mdeslaur/fm1608-to-5101/docs/top-3d.png

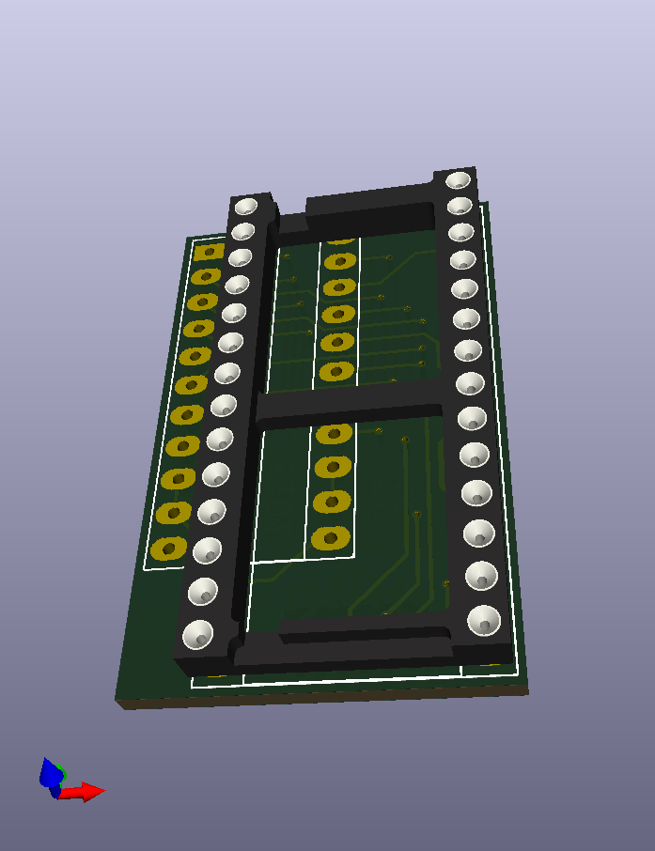
docs/top-3d.png
