mdeslaur/fm1608-to-5101/docs/bottom-3d.png

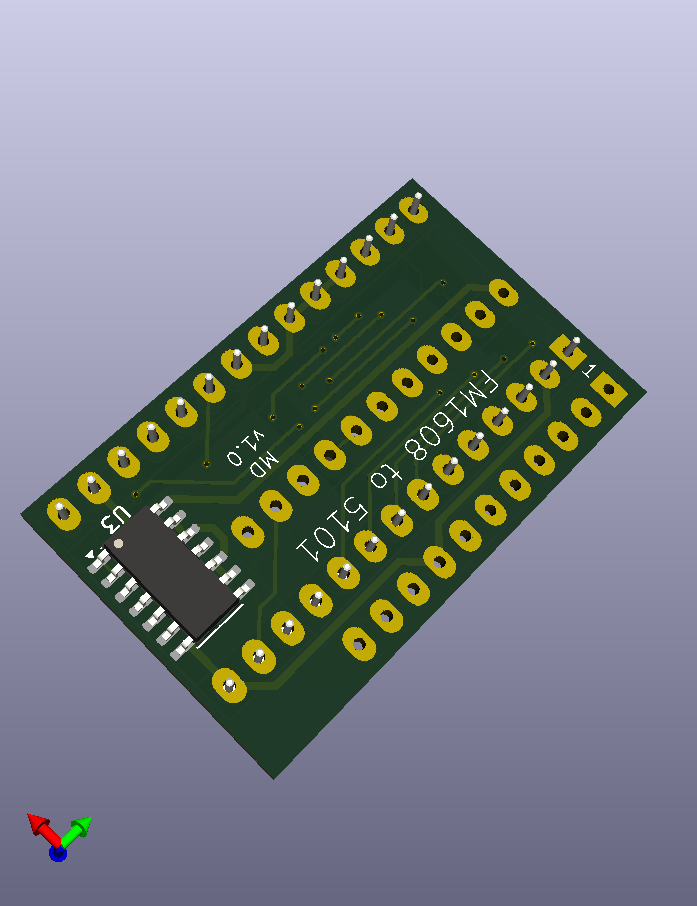
docs/bottom-3d.png
