mdeslaur/fm1608-to-5101/docs/fm1608-to-5101.pdf

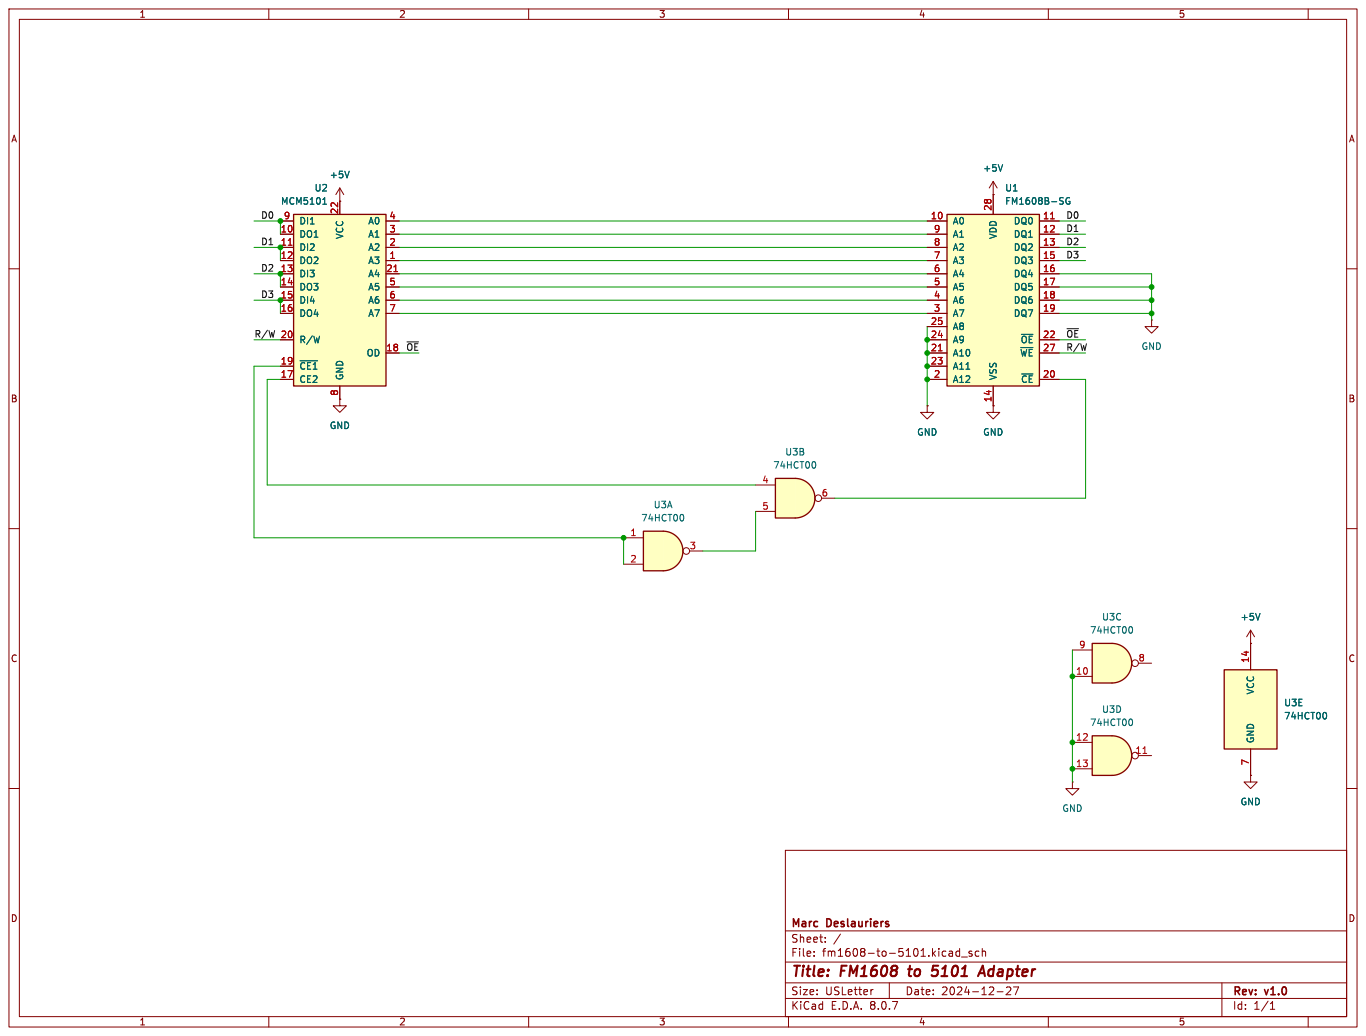
[picture p3: page 1]
