mdeslaur/fm1608-to-5101/fm1608-to-5101.kicad_pcb

## KiCad design fm1608-to-5101.kicad_pcb (2024-12-29)

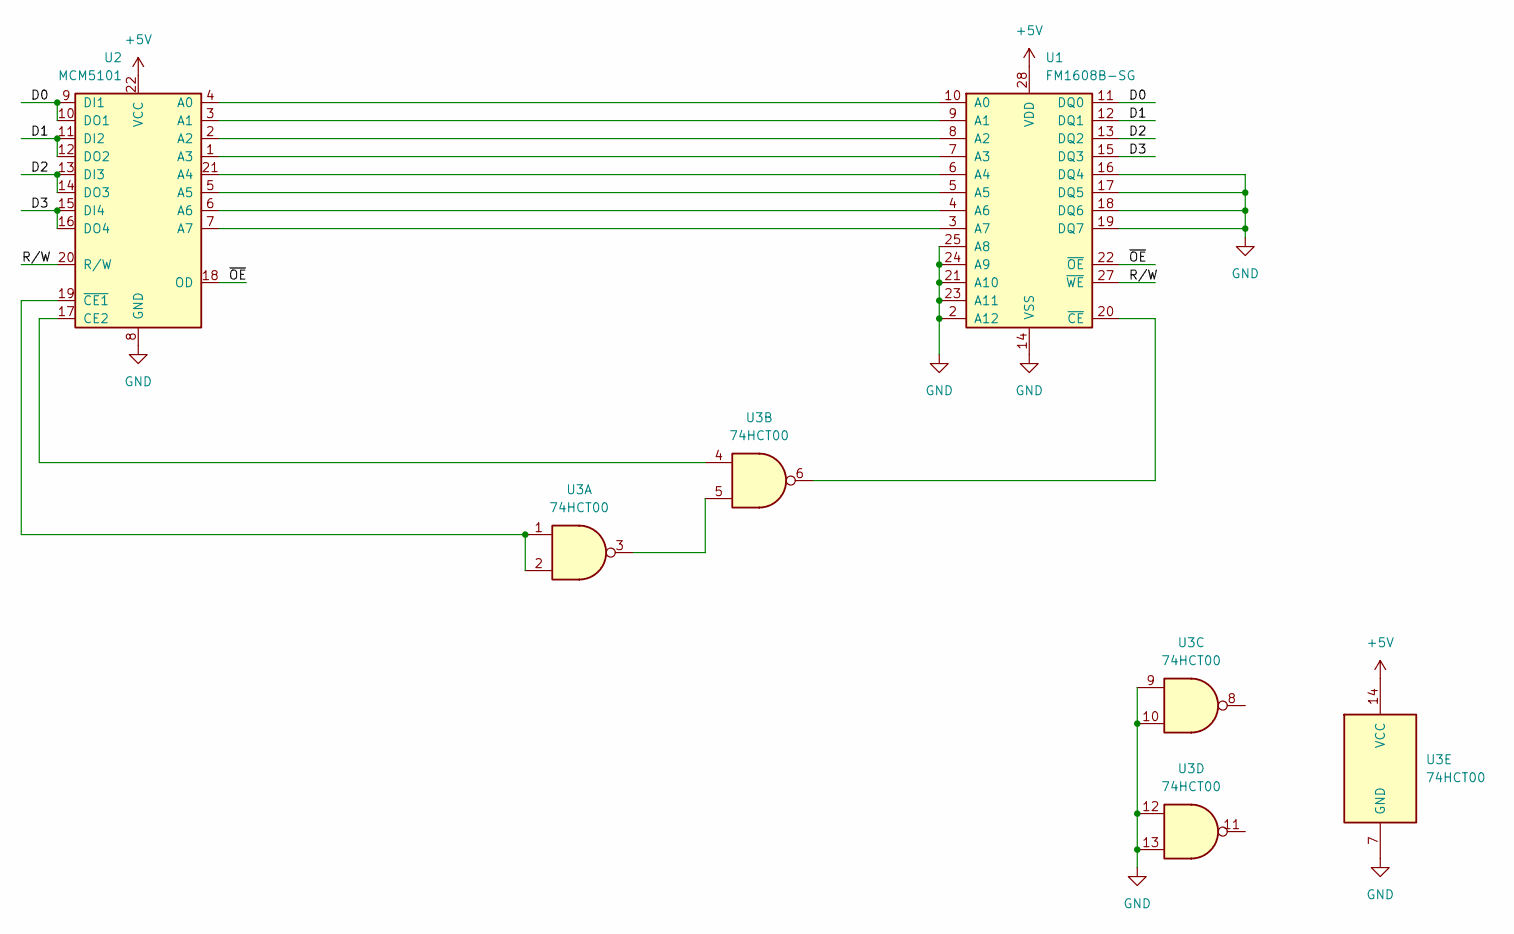
[picture p4: schematic fm1608-to-5101.kicad_sch, FM1608 to 5101 Adapter]

Parts:
U1: FM1608B-SG; DIP-28_W15.24mm_Socket_LongPads
U2: MCM5101; DIP-22_W10.16mm_Socket_LongPads
U3: 74HCT00; SOIC-14_3.9x8.7mm_P1.27mm; LCSC Part # C6764

Connections:
+5V: U1.28 (VDD), U2.22 (VCC), U3.14 (VCC)
/D0: U1.11 (DQ0), U2.9 (DI1), U2.10 (DO1)
/D1: U1.12 (DQ1), U2.11 (DI2), U2.12 (DO2)
/D2: U1.13 (DQ2), U2.13 (DI3), U2.14 (DO3)
/D3: U1.15 (DQ3), U2.15 (DI4), U2.16 (DO4)
/R/W: U1.27 (~WE), U2.20 (R/W)
/~OE: U1.22 (~OE), U2.18 (OD)
GND: U1.2 (A12), U1.14 (VSS), U1.16 (DQ4), U1.17 (DQ5), U1.18 (DQ6), U1.19 (DQ7), U1.21 (A10), U1.23 (A11), U1.24 (A9), U1.25 (A8), U2.8 (GND), U3.7 (GND), U3.9, U3.10, U3.12, U3.13
unnamed: U1.10 (A0), U2.4 (A0)
unnamed: U1.9 (A1), U2.3 (A1)
unnamed: U1.8 (A2), U2.2 (A2)
unnamed: U1.7 (A3), U2.1 (A3)
unnamed: U1.6 (A4), U2.21 (A4)
unnamed: U1.5 (A5), U2.5 (A5)
unnamed: U1.4 (A6), U2.6 (A6)
unnamed: U1.3 (A7), U2.7 (A7)
unnamed: U1.20 (~CE), U3.6
unnamed: U2.17 (CE2), U3.4
unnamed: U2.19 (~CE1), U3.1, U3.2
unnamed: U3.3, U3.5

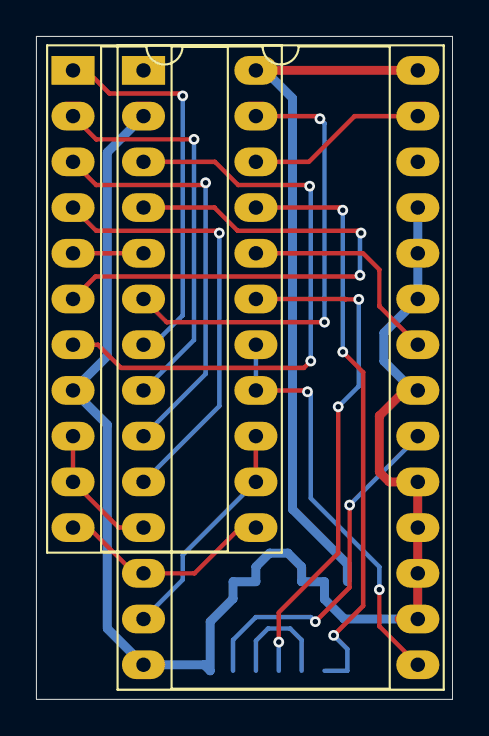
[picture p5: board fm1608-to-5101.kicad_pcb from above]

Board: 2 copper layers, 23.1 x 36.8 mm, 3 parts (1 on the bottom side), 20 nets.
